Yuri-Mojito/SPM_Robot_3DOF_Controlled_by_Dualsense_IMUs/hardware/renders/WhatsApp Image 2025-11-12 at 20.56.19.jpeg

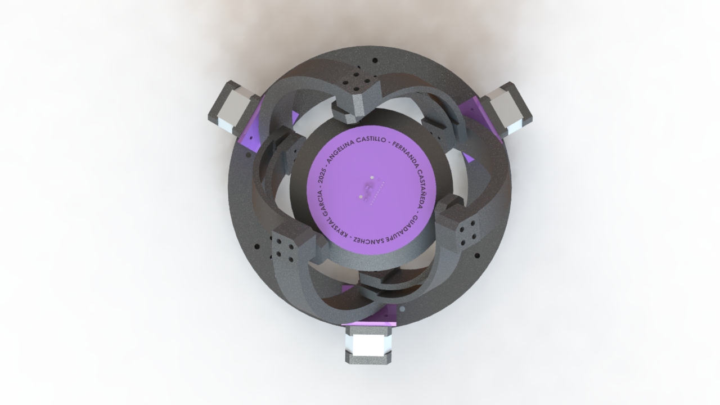
hardware/renders/WhatsApp Image 2025-11-12 at 20.56.19.jpeg
