Yuri-Mojito/SPM_Robot_3DOF_Controlled_by_Dualsense_IMUs/hardware/renders/preview2.JPG

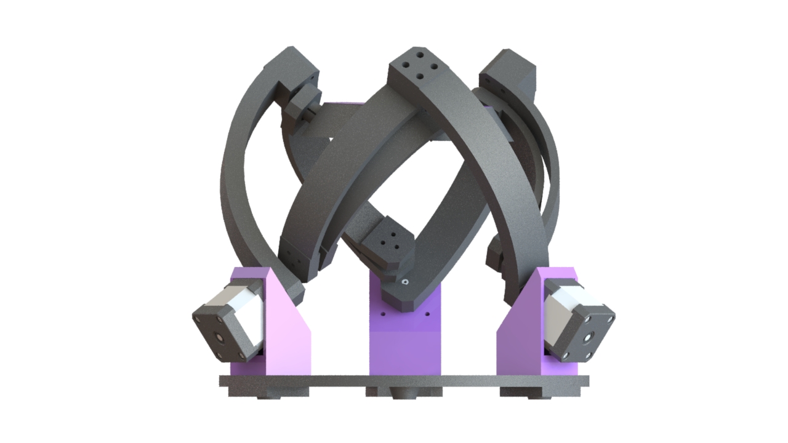
hardware/renders/preview2.JPG
