Yuri-Mojito/SPM_Robot_3DOF_Controlled_by_Dualsense_IMUs/hardware/cads/Schematic_MPU_2025-11-17.pdf

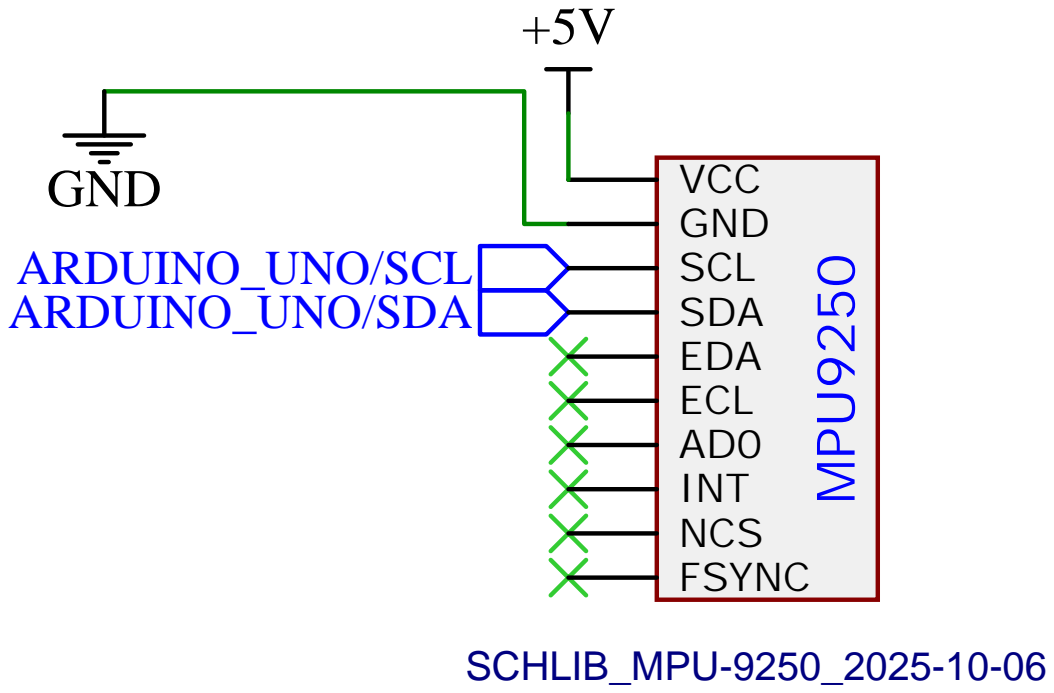
[picture p21: page 1]

CONEXION DE MPU 9250 A ARDUINO UNO
