Yuri-Mojito/SPM_Robot_3DOF_Controlled_by_Dualsense_IMUs/hardware/cads/Schematic_1CNC_SHIEL_20-11-20.pdf

U1

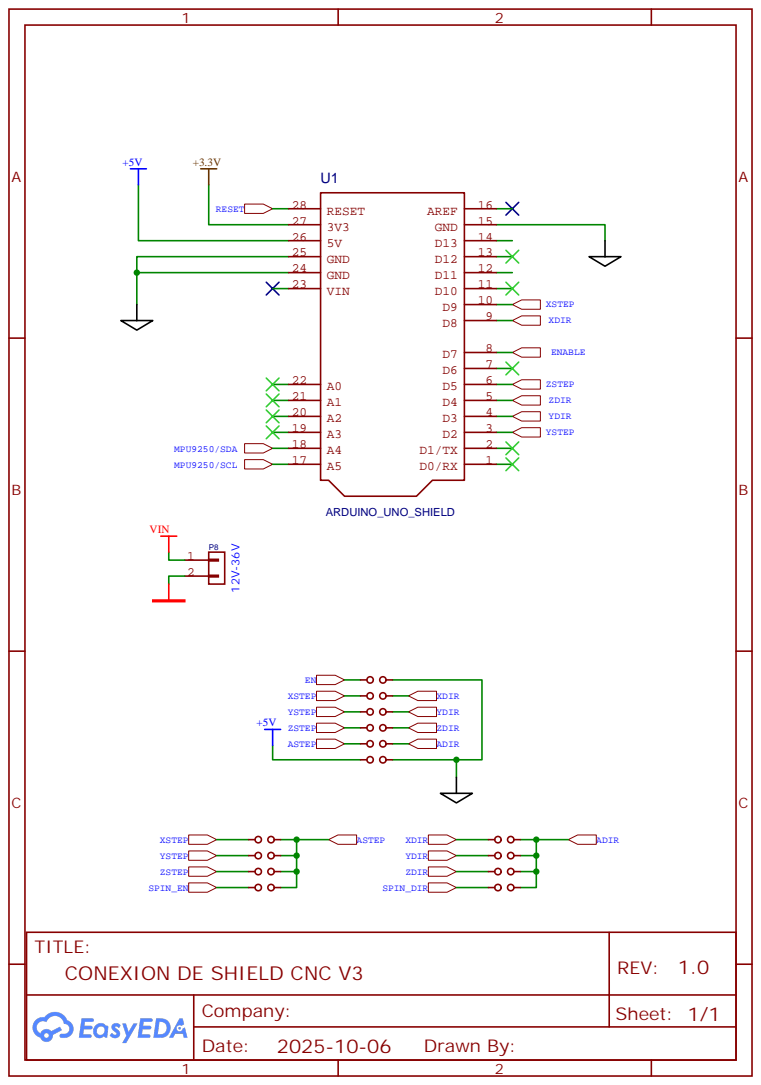
[picture p22: page 1]

TITLE:
CONEXION DE SHIELD CNC V3
