Yuri-Mojito/SPM_Robot_3DOF_Controlled_by_Dualsense_IMUs/hardware/cads/Schematic_2CNC_SHIEL_20-11-20.pdf

100uF

C1

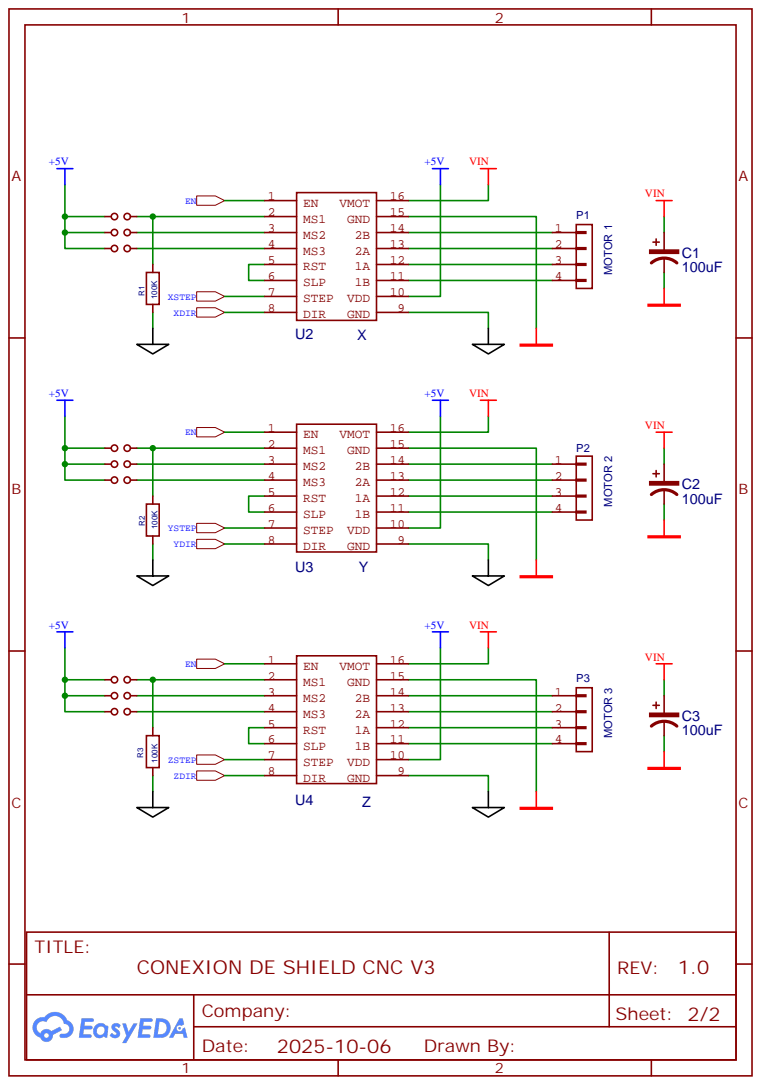
[picture p23: page 1]

CONEXION DE SHIELD CNC V3
